SENERGY-Platform/electricity-meter-controller/hardware/parts.xlsx

Part | Link
Male 4 Pin Header | https://www.digikey.de/product-detail/en/hirose-electric-co-ltd/DF1BZ-4DP-2.5DS/H11025-ND/1033155
Female 4 Pin Socket | https://www.digikey.de/product-detail/en/hirose-electric-co-ltd/DF1B-4DS-2.5RC/H3810-ND/558521
Socket Crimp | https://www.digikey.de/product-detail/en/hirose-electric-co-ltd/DF1B-2428SCF/H3832CT-ND/558620
Cable | https://www.digikey.de/product-detail/en/tensility-international-corp/30-00389/T1288-1-ND/5270264
Phototransistor | https://www.digikey.de/product-detail/en/vishay-semiconductor-opto-division/CNY70/751-1025-ND/1681159
39 Ohm 5% 1W | https://www.digikey.de/product-detail/en/vishay-bc-components/PR01000103909JR500/PPC39W-1CT-ND/597251
Dip Switch 5 Pos | https://www.digikey.de/product-detail/en/cts-electrocomponents/208-5/CT2085-ND/20786
680 kOhm 5% 1/4W | https://www.digikey.de/product-detail/en/stackpole-electronics-inc/CF14JT680K/CF14JT680KCT-ND/1830419
100 Ohm 5% 1/2W | https://www.digikey.de/product-detail/en/stackpole-electronics-inc/CFM12JT100R/S100HCT-ND/2617546
Potentiometer 10 kOhm 10% 1/2W | https://www.digikey.de/product-detail/en/nidec-copal-electronics/CT6EP103/CT6EP103-ND/738304
LED | https://www.digikey.com/product-detail/en/cree-inc/C5SMF-BJE-CR0U0451/C5SMF-BJE-CR0U0451-ND/4793773
82 Ohm 5% 1/4W | https://www.digikey.de/product-detail/en/yageo/CFR-25JB-52-82R/82QBK-ND/3609
Male 12 Pin Header | https://www.digikey.de/product-detail/en/3m/929834-04-12-RK/3M156868-12-ND/1093797
