SENERGY-Platform/electricity-meter-controller/hardware/head.brd

## EAGLE design hardware/head.brd (2018-05-16)

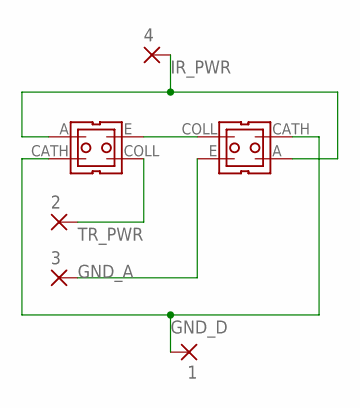
[picture p1: schematic head.sch]

Parts:
1, 2, 3, 4: 2,15/1,0
U$1, U$2: CNY70

Connections:
GND_A: 3.1, U$2.E (GND(PWR))
GND_D: 1.1, U$1.CATH (GND(DIG)), U$2.CATH (GND(DIG))
IR_PWR: 4.1, U$1.A (5V(DIG)), U$2.A (5V(DIG))
unnamed: U$1.E (GND(PWR)), U$2.COLL (5V(PWR))
TR_PWR: 2.1, U$1.COLL (5V(PWR))

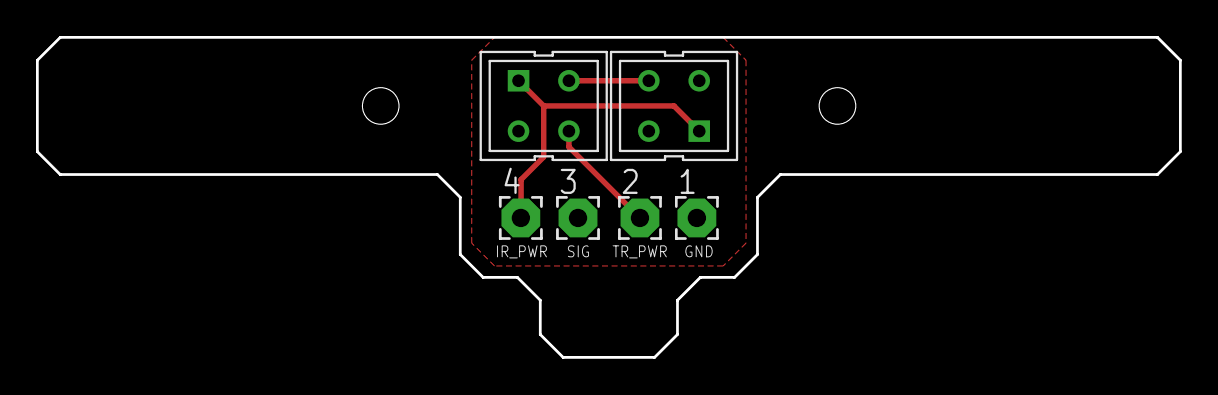
[picture p2: board head.brd from above]

Board: 2 copper layers, 63.5 x 17.8 mm, 6 parts (0 on the bottom side), 5 nets.
