SENERGY-Platform/electricity-meter-controller/hardware/base.brd

## EAGLE design hardware/base.brd (2018-05-16)

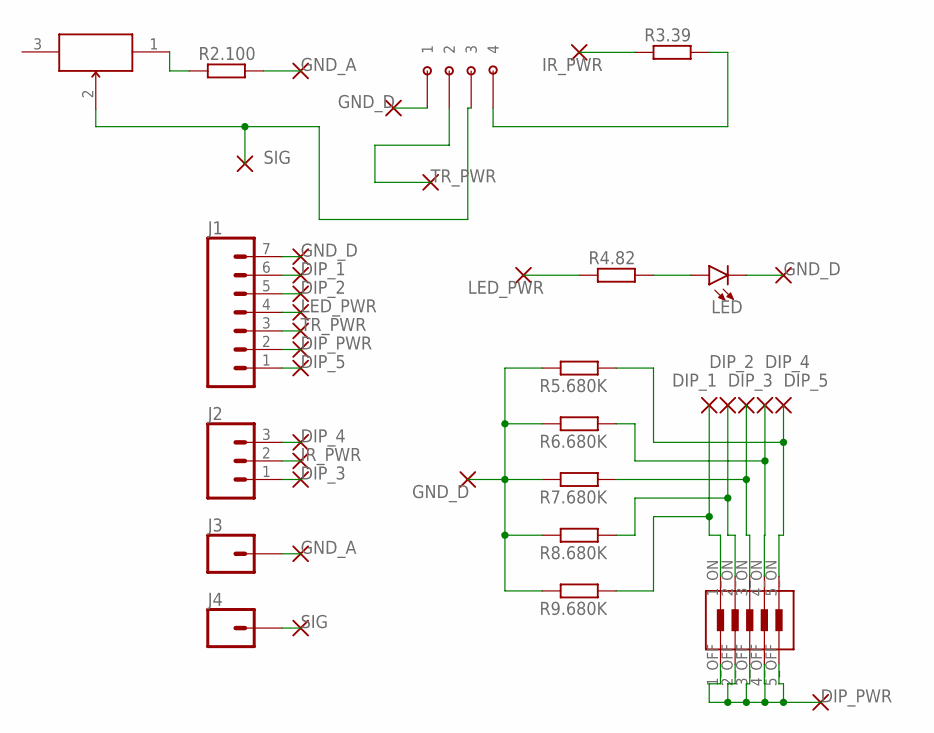
[picture p3: schematic base.sch]

Parts:
J1: CONN_07; 1X07
J2: CONN_03; 1X03
J3, J4: CONN_01; 1X01
LED: LED-3MM-NO_SILK; LED_3MM-NS
R2.100, R3.39, R4.82, R5.680K, R6.680K, R7.680K, R8.680K, R9.680K: R-EU_0204/7; 0204/7
U$1: DF1BZ-4DP-2.5DS
U$2: DIP-SW-CTS-208-5
U$3: CT6EP103

Connections:
DIP_1: J1.6, R9.680K.1, U$2.1_ON
DIP_2: J1.5, R8.680K.1, U$2.2_ON
DIP_3: J2.1, R7.680K.1, U$2.3_ON
DIP_4: J2.3, R6.680K.1, U$2.4_ON
DIP_5: J1.1, R5.680K.1, U$2.5_ON
DIP_PWR: J1.2, U$2.1_OFF, U$2.2_OFF, U$2.3_OFF, U$2.4_OFF, U$2.5_OFF
GND_A: J3.1, R2.100.2
GND_D: J1.7, LED.K (C), R5.680K.2, R6.680K.2, R7.680K.2, R8.680K.2, R9.680K.2, U$1.1
IR_PWR: J2.2, R3.39.1
LED_PWR: J1.4, R4.82.1
unnamed: R2.100.1, U$3.1
unnamed: R3.39.2, U$1.4
unnamed: LED.A, R4.82.2
P$1: U$3.3
SIG: J4.1, U$1.3, U$3.2
TR_PWR: J1.3, U$1.2

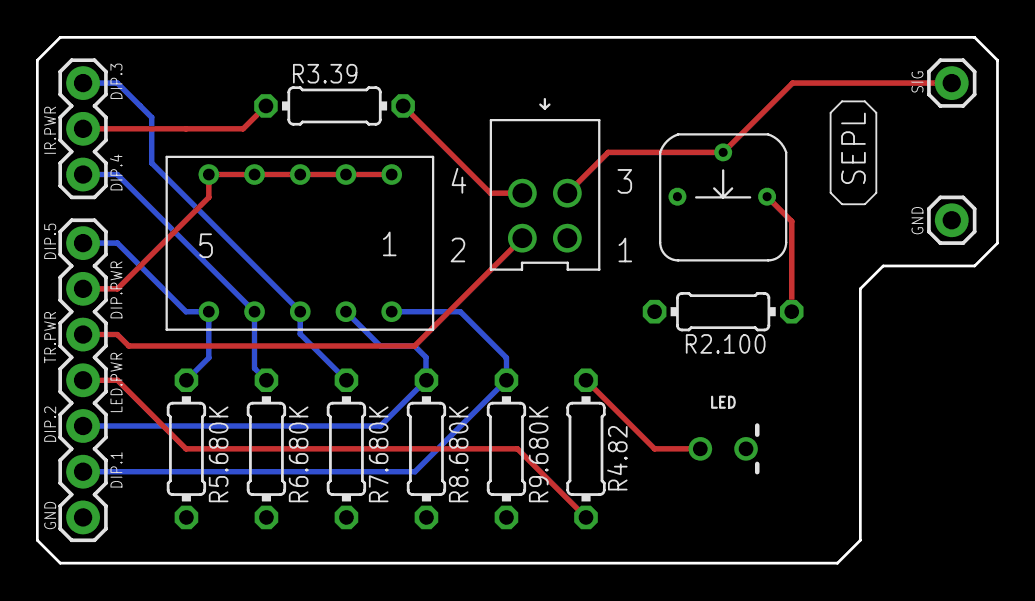
[picture p4: board base.brd from above]

Board: 2 copper layers, 53.3 x 29.2 mm, 16 parts (0 on the bottom side), 15 nets.
