SENERGY-Platform/electricity-meter-controller/single_sensor.brd

## EAGLE design single_sensor.brd (2018-03-15)

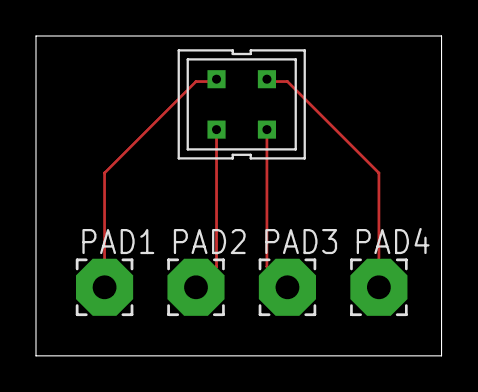
[picture p5: board single_sensor.brd from above]

Board: 2 copper layers, 22.5 x 17.8 mm, 5 parts (0 on the bottom side), 4 nets.

Parts:
PAD1, PAD2, PAD3, PAD4: WIREPAD3,17/1,3; 3,17/1,3
U$1: CNY70

Connections:
unnamed: PAD1.1, U$1.A
unnamed: PAD2.1, U$1.CATH
unnamed: PAD4.1, U$1.E
unnamed: PAD3.1, U$1.COLL
