SENERGY-Platform/electricity-meter-controller/(commit log)

2018-01-23 added LED feedback
2018-01-25 disable LED to avoid errors in dark envs
2018-01-29 added reset on failure and more LED feedback
2018-02-01 refactor and reduced dynamic memory footprint by 20%
2018-02-01 more refactoring and further reduction of memory footprint
2018-02-28 added circuit
2018-03-01 added dip switch ID
2018-03-21 changed routing
    [base.brd, base.sch]
2018-03-26 init dual sensor version
    [dual_sensor.sch]
2018-03-27 updated for new circuit
2018-03-28 added parts list
    [parts_list.xlsx]
2018-04-03 changes for new pin layout
2018-04-09 adjusted for new PCB
2018-04-09 added cable
    [parts_list.xlsx]
2018-04-09 changed parts
    [parts_list.xlsx]
2018-04-09 updated layout and part
    [base.brd, base.sch]
2018-04-11 updated with vat
    [parts_list.xlsx]
2018-04-11 added aisler links
    [parts_list.xlsx]
2018-05-15 updated drills and pads
2018-05-15 updated for new part
    [base.brd, base.sch, head.brd, head.sch]
2018-05-28 switched to number ID
2018-09-05 project refactor
    [base.brd, base.sch, head.brd, head.sch, parts_get_ag.xlsx]
